rod520/pico-calc2/pico-calc2.kicad_pcb

## KiCad design pico-calc2.kicad_pcb (2026-11-12)

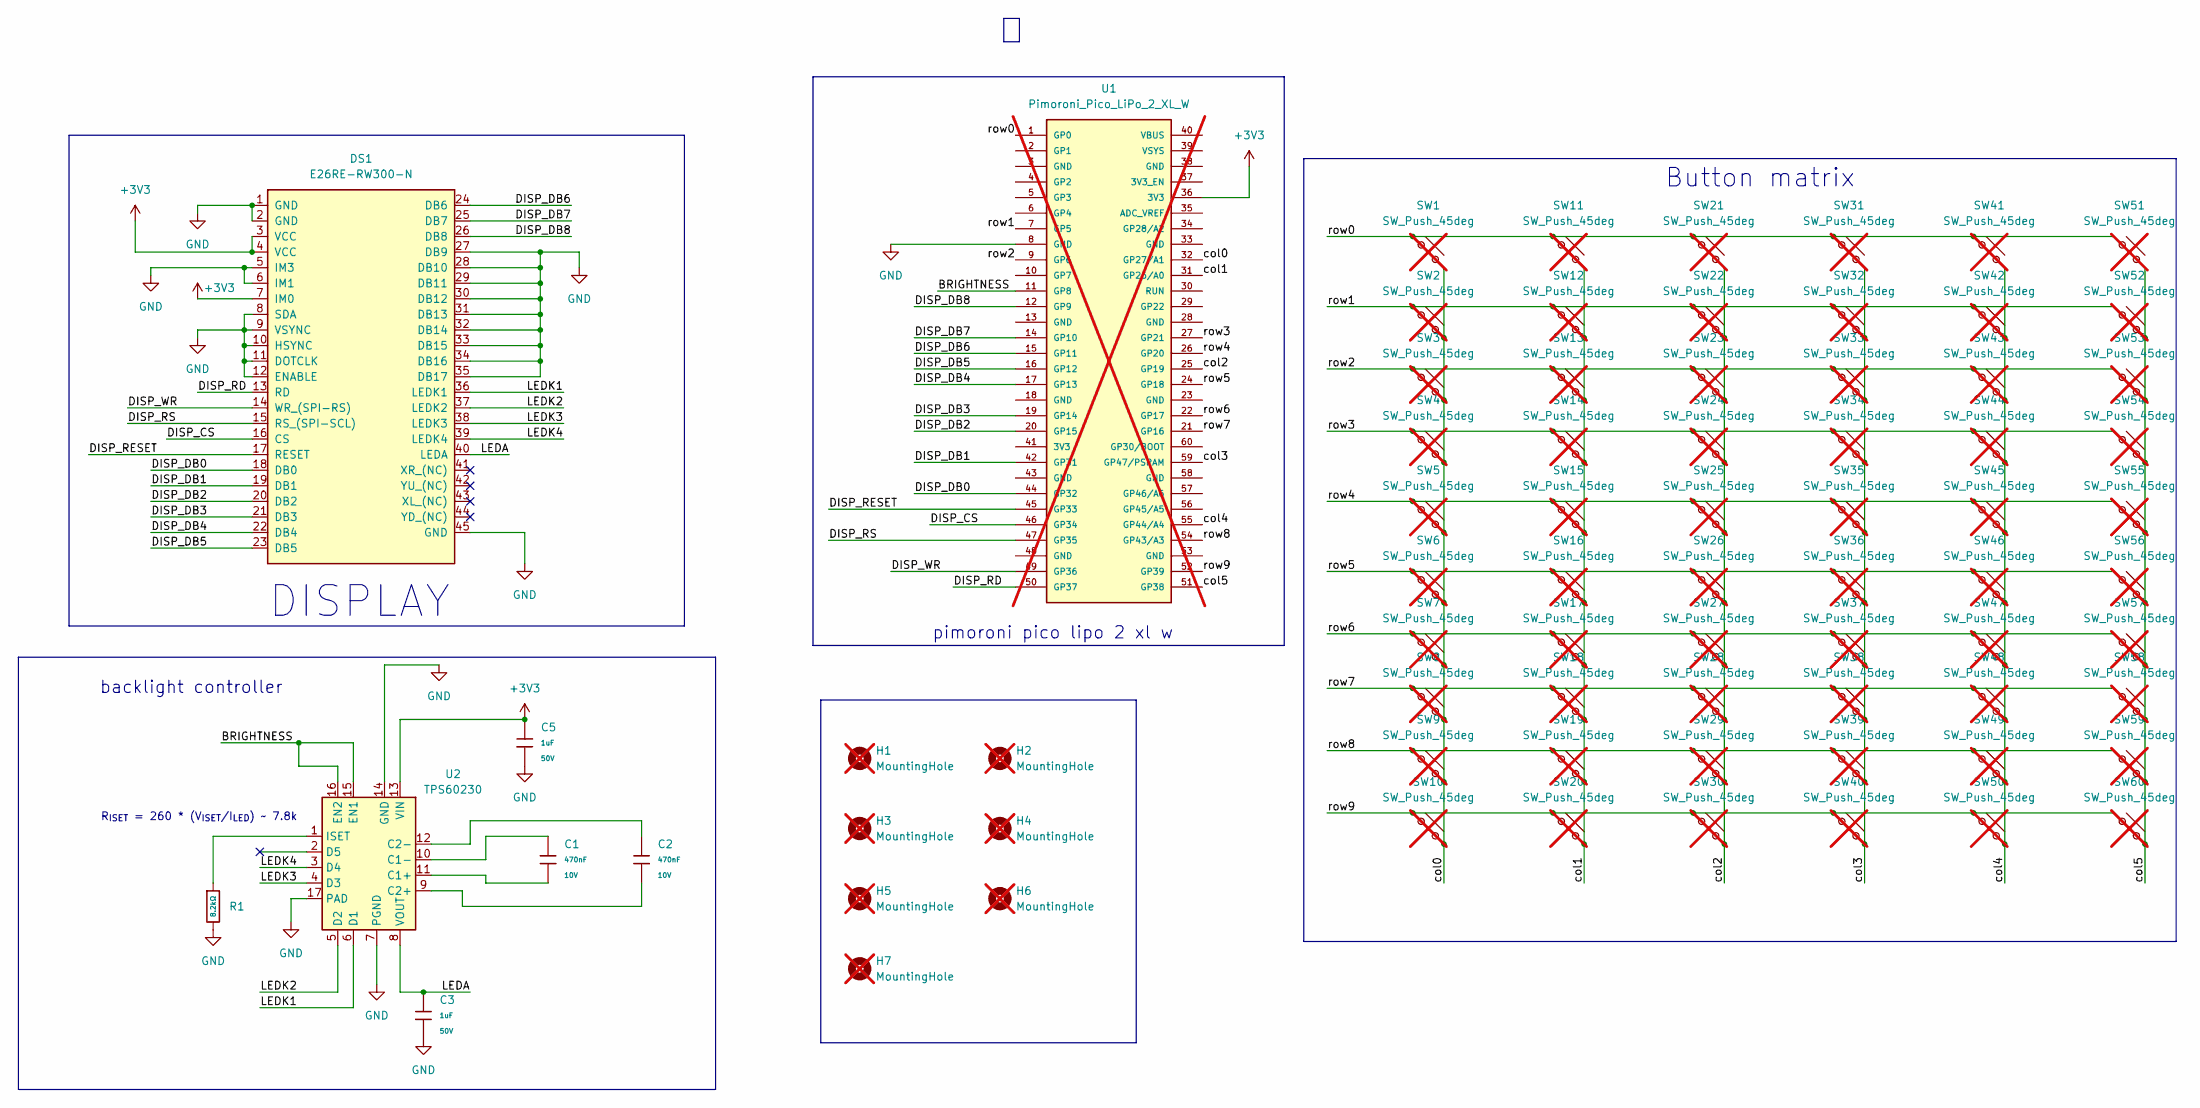
[picture p5: schematic pico-calc2.kicad_sch]

Parts:
C1, C2: 470nF; C_0402; Voltage Rated 10V; Tolerance ±10%; Part CL05A474KP5NNNC; LCSC C47339
C3, C5: 1uF; C_0603; Voltage Rated 50V; Tolerance ±10%; Part CL10A105KB8NNNC; LCSC C15849
DS1: E26RE-RW300-N; FPC-SMD_AFC01-S45FCA-00
H1, H2, H3, H4, H5, H6, H7: MountingHole; MountingHole_2.1mm; not fitted
R1: 8.2kΩ; R_0603; Overload Voltage (Max) 75V; Tolerance ±1%; Part 0603WAF8201T5E; LCSC C25981
SW1, SW2, SW3, SW4, SW5, SW6, SW7, SW8, SW9, SW10, SW11, SW12, SW13, SW14, SW15, SW16, SW17, SW18, SW19, SW20, SW21, SW22, SW23, SW24, SW25, SW26, SW27, SW28, SW29, SW30, SW31, SW32, SW33, SW34, SW35, SW36, SW37, SW38, SW39, SW40, SW41, SW42, SW43, SW44, SW45, SW46, SW47, SW48, SW49, SW50, SW51, SW52, SW53, SW54, SW55, SW56, SW57, SW58, SW59, SW60: SW_Push_45deg; SW-SMD_4P-L4.5-W4.5-P3.00-LS7.0; not fitted
U1: Pimoroni_Pico_LiPo_2_XL_W; Pimoroni Pico 2 XL W; not fitted
U2: TPS60230; VQFN-16_L3.0-W3.0-P0.50-TL-EP1.5

Connections:
+3V3: C5.1, DS1.3 (VCC), DS1.4 (VCC), DS1.7 (IM0), U1.36 (3V3), U1.41 (3V3), U2.13 (VIN)
/BRIGHTNESS: U1.11 (GP8), U2.15 (EN1), U2.16 (EN2)
/DISP_CS: DS1.16 (CS), U1.46 (GP34)
/DISP_DB0: DS1.18 (DB0), U1.44 (GP32)
/DISP_DB1: DS1.19 (DB1), U1.42 (GP31)
/DISP_DB2: DS1.20 (DB2), U1.20 (GP15)
/DISP_DB3: DS1.21 (DB3), U1.19 (GP14)
/DISP_DB4: DS1.22 (DB4), U1.17 (GP13)
/DISP_DB5: DS1.23 (DB5), U1.16 (GP12)
/DISP_DB6: DS1.24 (DB6), U1.15 (GP11)
/DISP_DB7: DS1.25 (DB7), U1.14 (GP10)
/DISP_DB8: DS1.26 (DB8), U1.12 (GP9)
/DISP_RD: DS1.13 (RD), U1.50 (GP37)
/DISP_RESET: DS1.17 (RESET), U1.45 (GP33)
/DISP_RS: DS1.15 (RS_(SPI-SCL)), U1.47 (GP35)
/DISP_WR: DS1.14 (WR_(SPI-RS)), U1.49 (GP36)
/LEDA: C3.1, DS1.40 (LEDA), U2.8 (VOUT)
/LEDK1: DS1.36 (LEDK1), U2.6 (D1)
/LEDK2: DS1.37 (LEDK2), U2.5 (D2)
/LEDK3: DS1.38 (LEDK3), U2.4 (D3)
/LEDK4: DS1.39 (LEDK4), U2.3 (D4)
/col0: SW1.2, SW2.2, SW3.2, SW4.2, SW5.2, SW6.2, SW7.2, SW8.2, SW9.2, SW10.2, U1.32 (GP27/A1)
/col1: SW11.2, SW12.2, SW13.2, SW14.2, SW15.2, SW16.2, SW17.2, SW18.2, SW19.2, SW20.2, U1.31 (GP26/A0)
/col2: SW21.2, SW22.2, SW23.2, SW24.2, SW25.2, SW26.2, SW27.2, SW28.2, SW29.2, SW30.2, U1.25 (GP19)
/col3: SW31.2, SW32.2, SW33.2, SW34.2, SW35.2, SW36.2, SW37.2, SW38.2, SW39.2, SW40.2, U1.59 (GP47/PSRAM)
/col4: SW41.2, SW42.2, SW43.2, SW44.2, SW45.2, SW46.2, SW47.2, SW48.2, SW49.2, SW50.2, U1.55 (GP44/A4)
/col5: SW51.2, SW52.2, SW53.2, SW54.2, SW55.2, SW56.2, SW57.2, SW58.2, SW59.2, SW60.2, U1.51 (GP38)
/row0: SW1.1, SW11.1, SW21.1, SW31.1, SW41.1, SW51.1, U1.1 (GP0)
/row1: SW2.1, SW12.1, SW22.1, SW32.1, SW42.1, SW52.1, U1.7 (GP5)
/row2: SW3.1, SW13.1, SW23.1, SW33.1, SW43.1, SW53.1, U1.9 (GP6)
/row3: SW4.1, SW14.1, SW24.1, SW34.1, SW44.1, SW54.1, U1.27 (GP21)
/row4: SW5.1, SW15.1, SW25.1, SW35.1, SW45.1, SW55.1, U1.26 (GP20)
/row5: SW6.1, SW16.1, SW26.1, SW36.1, SW46.1, SW56.1, U1.24 (GP18)
/row6: SW7.1, SW17.1, SW27.1, SW37.1, SW47.1, SW57.1, U1.22 (GP17)
/row7: SW8.1, SW18.1, SW28.1, SW38.1, SW48.1, SW58.1, U1.21 (GP16)
/row8: SW9.1, SW19.1, SW29.1, SW39.1, SW49.1, SW59.1, U1.54 (GP43/A3)
/row9: SW10.1, SW20.1, SW30.1, SW40.1, SW50.1, SW60.1, U1.52 (GP39)
GND: C3.2, C5.2, DS1.1 (GND), DS1.2 (GND), DS1.5 (IM3), DS1.6 (IM1), DS1.8 (SDA), DS1.9 (VSYNC), DS1.10 (HSYNC), DS1.11 (DOTCLK), DS1.12 (ENABLE), DS1.27 (DB9), DS1.28 (DB10), DS1.29 (DB11), DS1.30 (DB12), DS1.31 (DB13), DS1.32 (DB14), DS1.33 (DB15), DS1.34 (DB16), DS1.35 (DB17), DS1.45 (GND), R1.2, U1.3 (GND), U1.8 (GND), U1.13 (GND), U1.18 (GND), U1.23 (GND), U1.28 (GND), U1.33 (GND), U1.38 (GND), U1.43 (GND), U1.48 (GND), U1.53 (GND), U1.58 (GND), U2.7 (PGND), U2.14 (GND), U2.17 (PAD)
unnamed: C1.2, U2.11 (C1+)
unnamed: C1.1, U2.10 (C1-)
unnamed: C2.2, U2.9 (C2+)
unnamed: C2.1, U2.12 (C2-)
unnamed: R1.1, U2.1 (ISET)

Notes on the sheet:
DISPLAY
R_{ISET} = 260 * (V_{ISET}/I_{LED}) ~ 7.8k
Button matrix
backlight controller
pimoroni pico lipo 2 xl w

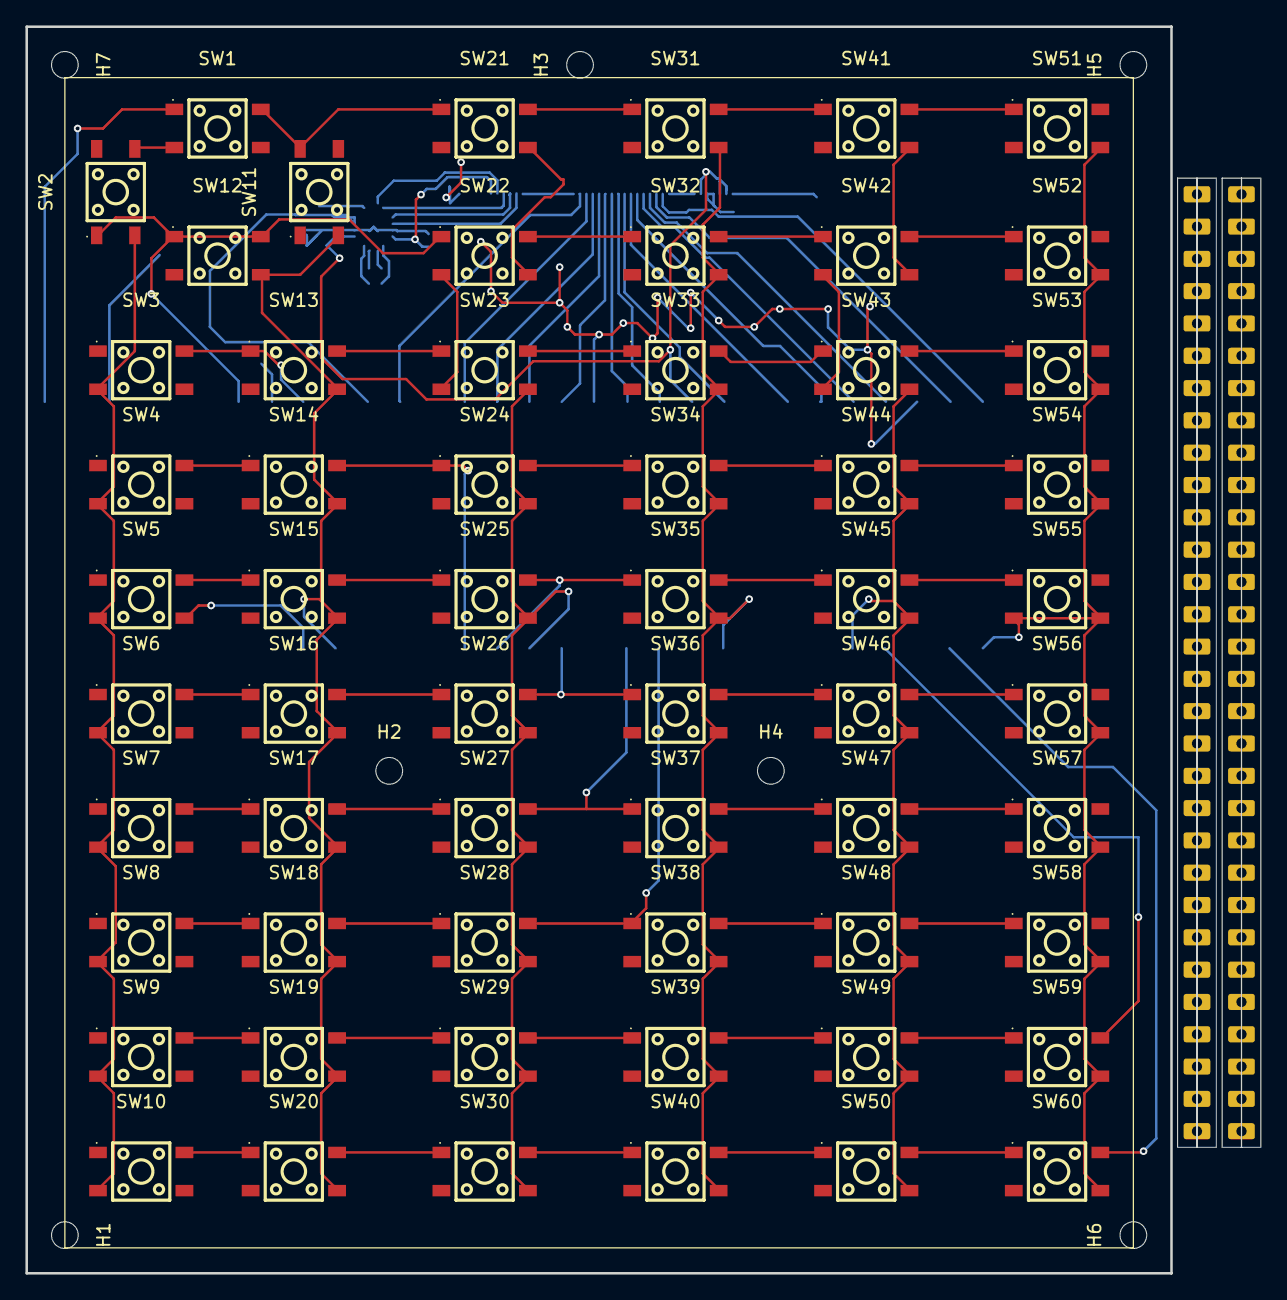
[picture p6: board pico-calc2.kicad_pcb from above]

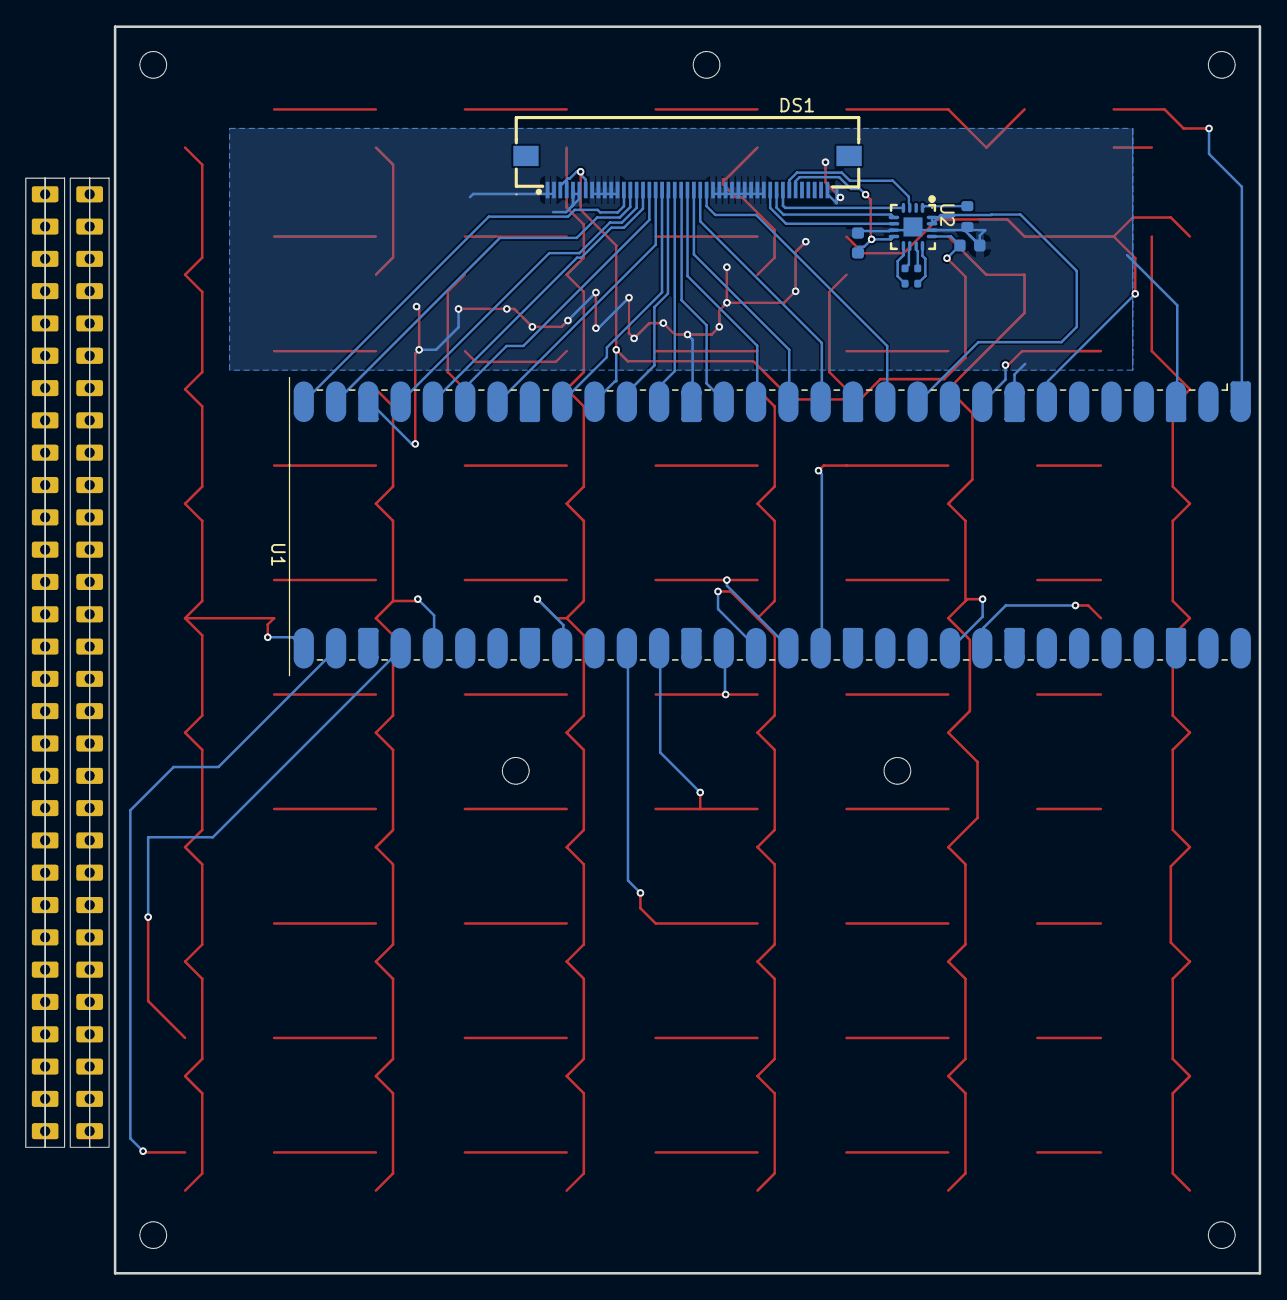
[picture p7: board pico-calc2.kicad_pcb from below]

Board: 2 copper layers, 97.0 x 98.0 mm, 75 parts (8 on the bottom side), 43 nets.
