rod520/pico-calc2/(commit log)

2026-10-26 move everything to the main directory
    [pico-calc2.kicad_pcb, pico-calc2.kicad_sch]
2026-10-27 oijojojaf'skjdkfjalsdklfjsa
    asdfasdf
    [pico-calc2.kicad_pcb, pico-calc2.kicad_sch]
2026-11-07 afasdfdafa
    d
    [pico-calc2.kicad_sch]
2026-11-07 final update
    [pico-calc2.kicad_pcb]
2026-11-07 actually this should be final
    [pico-calc2.kicad_sch]
2026-11-07 Revise assembly instructions and add images
    Updated assembly instructions and added images section with relevant images.
2026-11-07 Rename castellated frame.png to castellated-frame.png
2026-11-07 Add castellated frame image to README
    Added image for castellated frame in README.
2026-11-07 Update BOM section header in README.md
2026-11-12 gerber, last parts
    [pico-calc2-B_Cu.gbr, pico-calc2-B_Mask.gbr, pico-calc2-B_Paste.gbr, pico-calc2-B_Silkscreen.gbr, pico-calc2-CuBottom.gbr, pico-calc2-CuTop.gbr, pico-calc2-EdgeCuts.gbr, pico-calc2-Edge_Cuts.gbr]
2026-11-12 some more changes
    [pico-calc2-B_Cu.gbr, pico-calc2-B_Mask.gbr, pico-calc2-B_Paste.gbr, pico-calc2-B_Silkscreen.gbr, pico-calc2-CuBottom.gbr, pico-calc2-CuTop.gbr, pico-calc2-EdgeCuts.gbr, pico-calc2-Edge_Cuts.gbr]
